yixuanh097/Point2PointCommunication/circuits/Point2PointCommunication.kicad_sch

## KiCad design circuits/Point2PointCommunication.kicad_sch (2026-07-21)

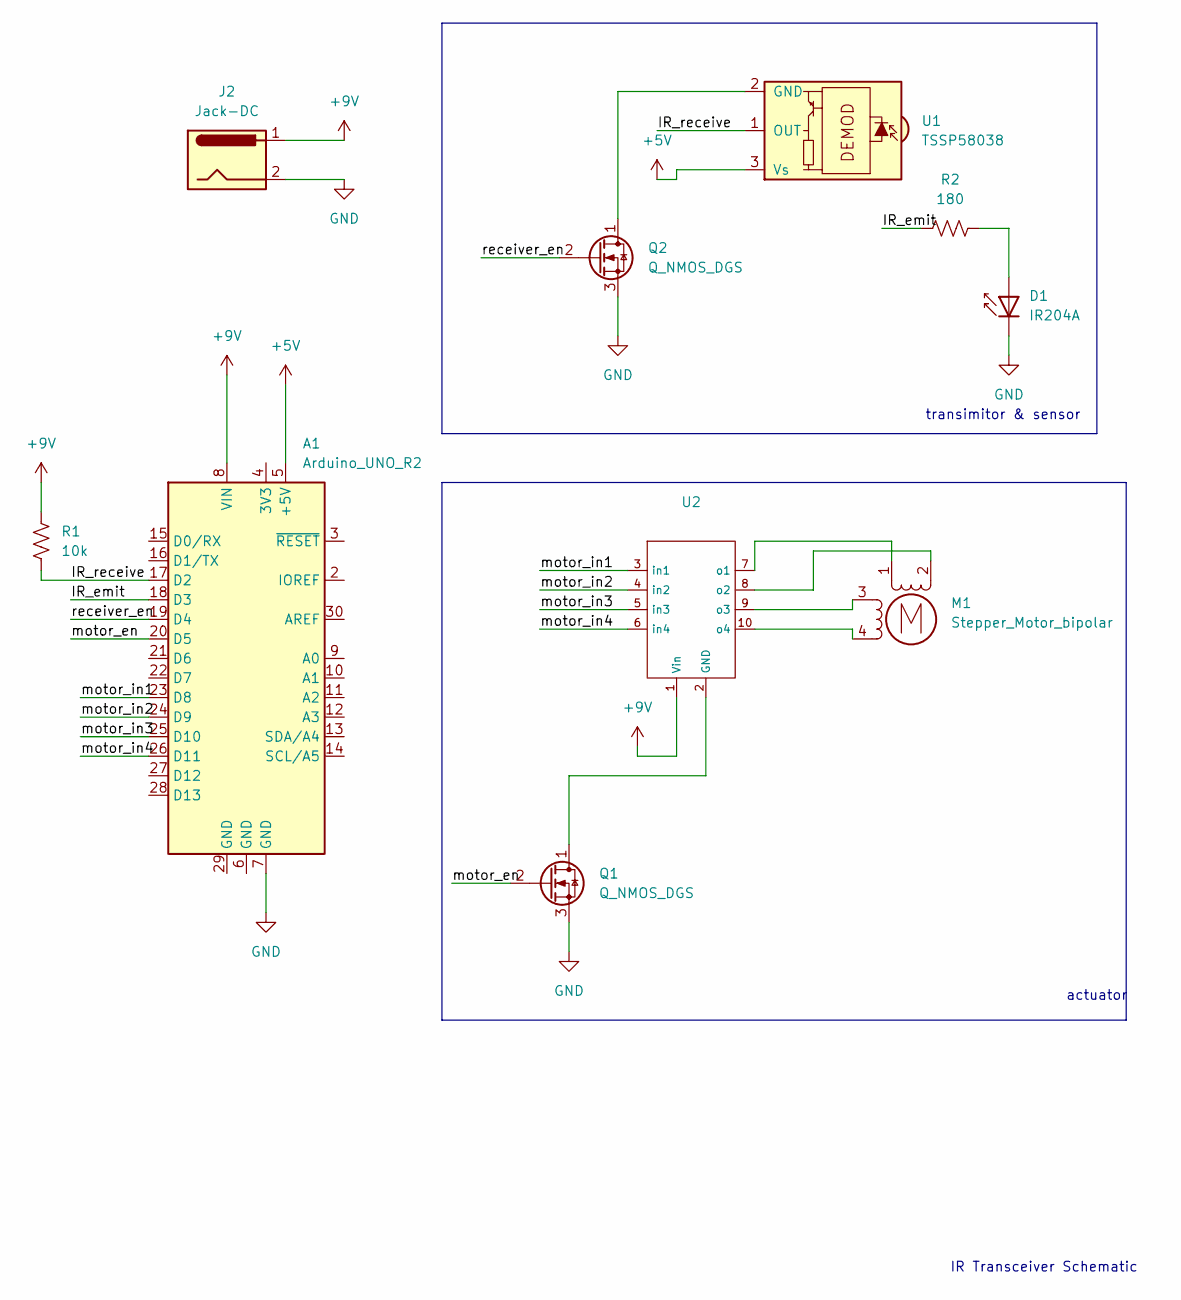
[picture p1: schematic Point2PointCommunication.kicad_sch]

Parts:
A1: Arduino_UNO_R2
D1: IR204A; LED_D3.0mm_IRBlack
J2: Jack-DC
M1: Stepper_Motor_bipolar
Q1, Q2: Q_NMOS_DGS
R1: 10k
R2: 180
U1: TSSP58038; Vishay_MINICAST-3Pin
U2: (no value)

Connections:
+5V: A1.5 (+5V), U1.3 (Vs)
+9V: A1.8 (VIN), J2.1, R1.1, U2.1 (Vin)
GND: A1.7 (GND), D1.1 (K), J2.2, Q1.3 (S), Q2.3 (S)
IR_emit: A1.18 (D3), R2.2
IR_receive: A1.17 (D2), R1.2, U1.1 (OUT)
unnamed: D1.2 (A), R2.1
unnamed: M1.1, U2.7 (o1)
unnamed: M1.2 (-), U2.8 (o2)
unnamed: M1.3, U2.9 (o3)
unnamed: M1.4, U2.10 (o4)
unnamed: Q1.1 (D), U2.2 (GND)
unnamed: Q2.1 (D), U1.2 (GND)
motor_en: A1.20 (D5), Q1.2 (G)
motor_in1: A1.23 (D8), U2.3 (in1)
motor_in2: A1.24 (D9), U2.4 (in2)
motor_in3: A1.25 (D10), U2.5 (in3)
motor_in4: A1.26 (D11), U2.6 (in4)
receiver_en: A1.19 (D4), Q2.2 (G)

Notes on the sheet:
actuator
IR Transceiver Schematic
transimitor & sensor
