yixuanh097/Point2PointCommunication/(commit log)

2026-07-21 inital commit
    [Point2PointCommunication.kicad_pcb, Point2PointCommunication.kicad_sch]
2026-07-25 fixed 0 after read issue and consecutive 1 inaccuracy
    [receiver.ino, transmitter.ino]
2026-07-26 generate ssh key, correctly mount repository
2026-07-28 changed keyPad pin to fixed row 2 reading issue
    [transmitter.ino]
2026-08-03 wiring testing in hw_check, see notes, module is the protocol
